Aryagarg23/makeuc-2026/research/tribe_v2/test12_mean.png

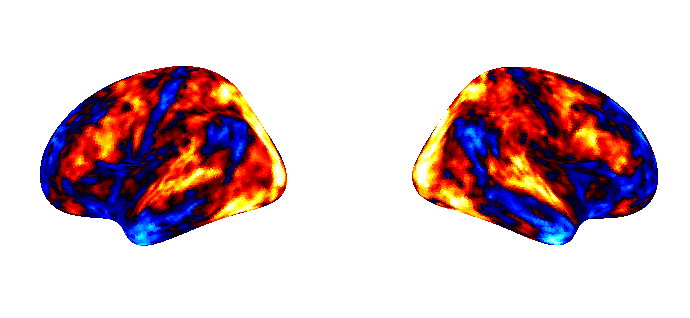
research/tribe_v2/test12_mean.png
