Aryagarg23/makeuc-2026/gvs/bench_log.md

# Bench log

Each run uses a 2.2 kΩ dummy load across the electrode leads, with nobody attached. Pulses are driven over USB serial by `tools/bench.py`. The board's reading is the firmware's own current readback; the meter reading is DC volts across the 2.2k, so true mA = V / 2.2.

## 2026-11-07

**Power.** With the battery feed wire on S1 col 19, the HV rail reads 3.85–3.89 V at idle on the board's own voltage reading.

**Boost sweep, open leads.** HV at each duty setting, on the board's own reading:

| Duty | 5% | 10% | 15% | 20% | 25% | 30% | 35% | 40% | 45% |
|---|---|---|---|---|---|---|---|---|---|
| HV (V) | 5.9 | 7.9 | 10.0 | 12.1 | 14.1 | 16.0 | 17.7 | 19.4 | 21.1 |

- 45% is the firmware ceiling (`BOOST_MAX_PCT`) and is now `BOOST_PCT`.
- During 3 s pulses with the leads open, HV peaked at 23–26.5 V. The cutoff is 28 V.
- Once the boost stops, HV bleeds back to about 3.9 V within about 1 s.

**Relays, open leads, 0.5 Hz sine.** The relay state went -1 → 0 → 1 → (-1) → 0 → -1: it alternated, and passed through released at each flip.

**Current into 2.2k, DC, 3 s:**

| Commanded | Meter | True current | Board's reading, before calibration | HV during pulse |
|---|---|---|---|---|
| 0.5 mA | 1.07 V | 0.486 mA | 0.69–0.72 | 21 V |
| 1.0 mA | 2.2 V | 1.00 mA | 1.13–1.14 | 19.5 V |
| 2.0 mA | 4.308 V | 1.958 mA | 1.92–2.03 | 17.0 V |

- With 0 mA commanded, the board read 0.25–0.28 mA, though no current was flowing. Taken together with the rows above, the uncorrected board reading follows **raw = 0.27 + 0.88 × true** in mA, so the error was in the measurement, not the output.
- The firmware now reports `meas_ma` with that correction. The overcurrent trip (2.3 mA) still uses the uncorrected reading, which runs at or above the true current up to about 2.25 mA.
- The meter reading at 0 mA commanded was not recorded.

## 2026-11-07, first on-head session (BLE, USB unplugged, Mac on battery)

Pads were placed on the mastoids. The kill switch had been removed; the plan was to pull a pad to stop.

| Time | Pulse | Felt |
|---|---|---|
| 22:48 | 0.5 mA, 1 Hz sine, 2 s | tingle |
| 22:49 | 0.75 mA, 1 Hz sine, 2 s | tingle |
| 22:49 | 1.0 mA, 1 Hz sine, 2 s | more tingle |
| 22:51 | 0.5 mA, 1/3 Hz sine, 3 s (pads moved) | (not reported) |
| 22:53–22:58 | DC 3 s at 1.0, 1.0, 1.25, 1.5, 1.5 mA, alternating sides | minor tingle |
| 23:04 | 1.0 mA DC (wire now cut into the pad's carbon layer) | stronger tingle |
| 23:12 | 1.0 mA DC (pads moved per diagram) | hurts a little / unusual |
| 23:13 | 1.25 mA DC | no balance change |
| 23:15 | 1.5 mA DC | hurts, on top of the skin; session stopped |

- **No vestibular effect at any level.** The board held the commanded current on every pulse, and there were no faults.
- **Likely cause: the electrode connection.** The pads have 2 mm female pin sockets. A bare wire was pushed into, then cut into, the carbon layer, so current reached the skin at a few points. That gives skin sensation, then pain, without enough current reaching the vestibular nerve.
- **Next session:**
  - Fresh pads, connected by 2 mm male pins (TENS lead wires or a tinned wire pin).
  - Check gel-to-gel resistance first: under about 1 kΩ, steady when the pins are wiggled.
  - During a 1.0 mA pulse, check that the voltage across the pads is 1–5 V.
  - Restart at 0.5 mA.

## 2026-11-08, battery flat overnight

- **Symptom:** Bluetooth not found.
- **On USB:** idle HV rail 2.48 V (3.75–3.88 V the night before), pulse log cleared, so the board had browned out and reset.
- **Charging over USB:** 2.82 → 3.11 V in 53 s.
- **Cause:** with no SSID, the firmware fell back to an always-on WiFi hotspot alongside BLE, and the 250 mAh LiPo couldn't sustain it overnight.
- **Fix:**
  - With no SSID, WiFi stays off and the HTTP server isn't started. The first build crashed in `xQueueSemaphoreTake` because `WebServer` touched lwIP while WiFi was off.
  - Boot now prints `WiFi off (no SSID)` and `BLE: GVS-zapper advertising`, and status works over BLE.
- **Battery:** went below about 3.0 V. Check it for swelling or heat while it recharges.

## 2026-11-08, live mode (browser tilt control)

- **Firmware:** `live <signed mA>` streams a target current. The board slews toward it at up to 4 mA/s, with the sign choosing the relay.
- **Limits:**
  - dead-man: 500 ms with no update ramps the output to 0 and ends the session
  - 60 s per session
  - 10 min of live time per rolling hour
  - |target| ≤ 1.5 mA
- **Checked over USB serial** at 0.3 mA, open leads or pads (not checked by meter):
  - streaming +0.3 holds 0.3 mA on relay 1
  - going silent reaches idle at 0.51 s, msg "live: controller silent, ramped off"
  - −0.3 mA moves to relay 2
  - −9 mA is clamped to −1.5
  - stop goes to idle
- **Relay (`ble_bridge.py`):**
  - Serves `live.html` at http://127.0.0.1:8765/; `/live?ma=` writes over BLE without waiting for a response.
  - Refuses any current (pulse, live, boost) while the Mac is on its charger **and** the board is on USB. Checked: `403 refused` for both /live and /cmd pulse while on AC with USB in.
- **A miss:** the serial checks above ran without that check, while the Mac was on AC with USB in.
