Aryagarg23/makeuc-2026/gvs/pictures/electrode_placement.png

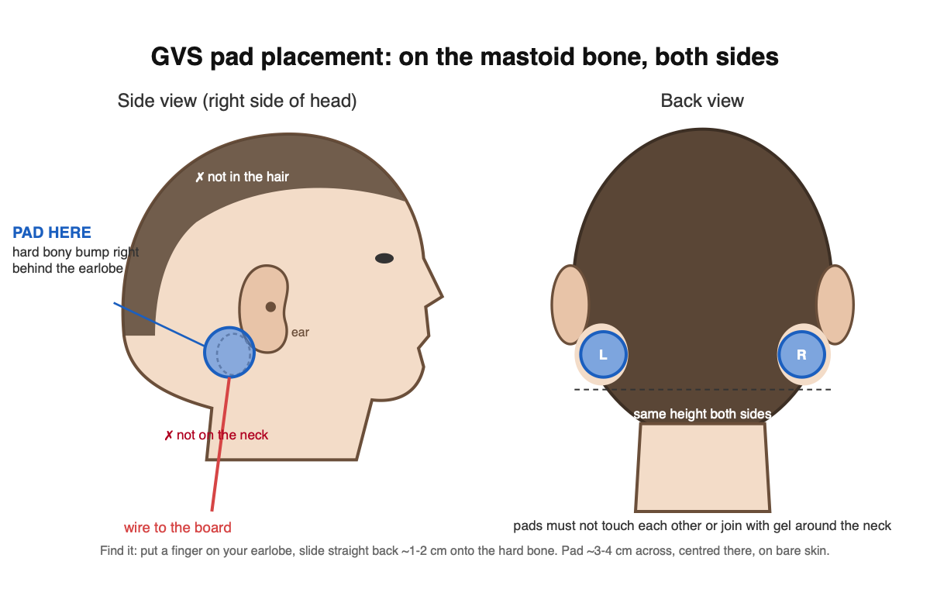
gvs/pictures/electrode_placement.png
