Aryagarg23/makeuc-2026/gvs/pictures/full_front.png

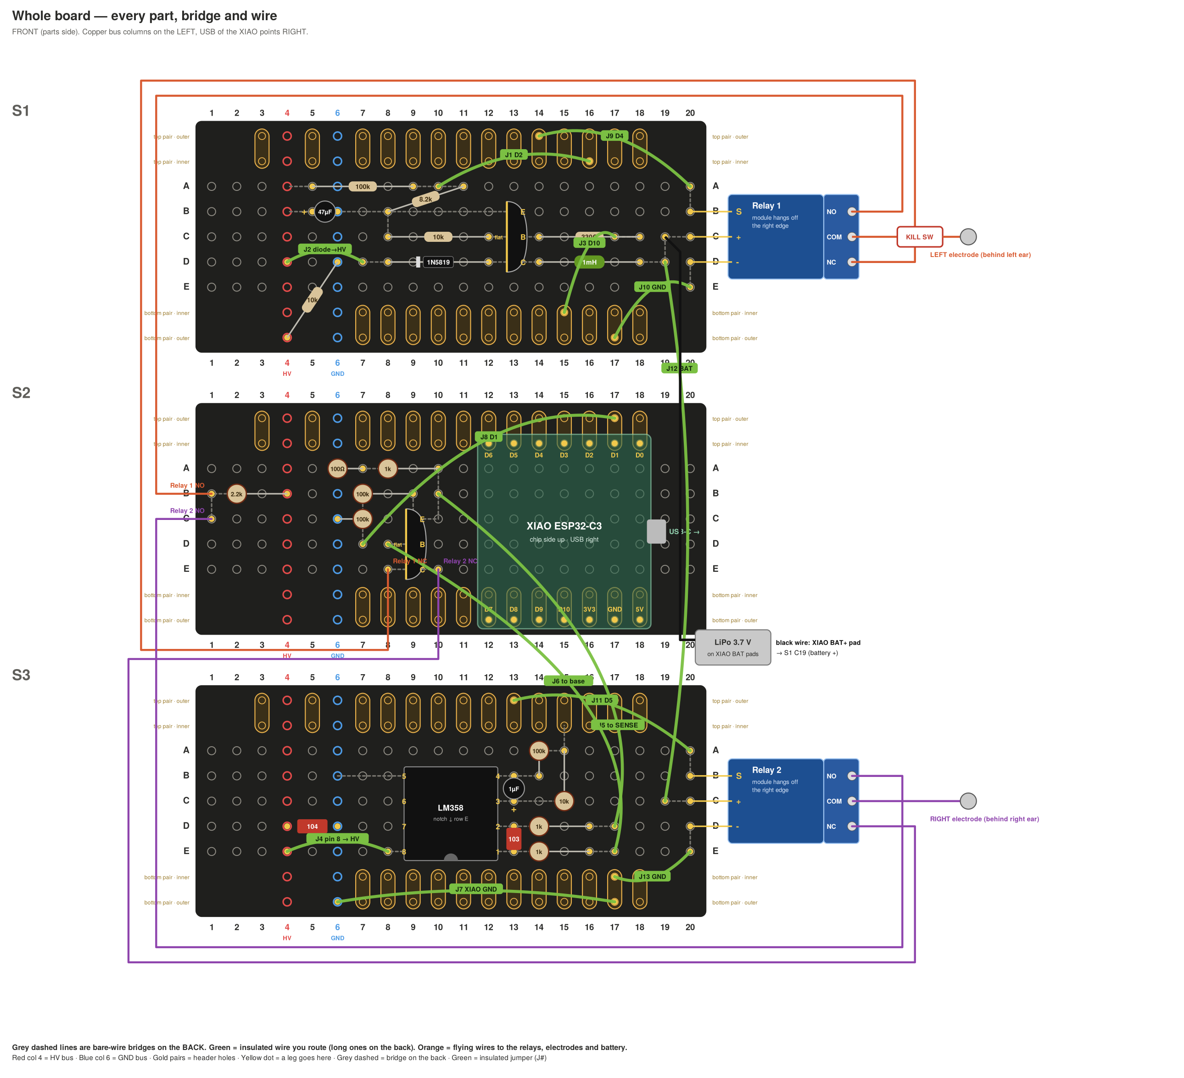
gvs/pictures/full_front.png
