Aryagarg23/makeuc-2026/gvs/pictures/S1_back.png

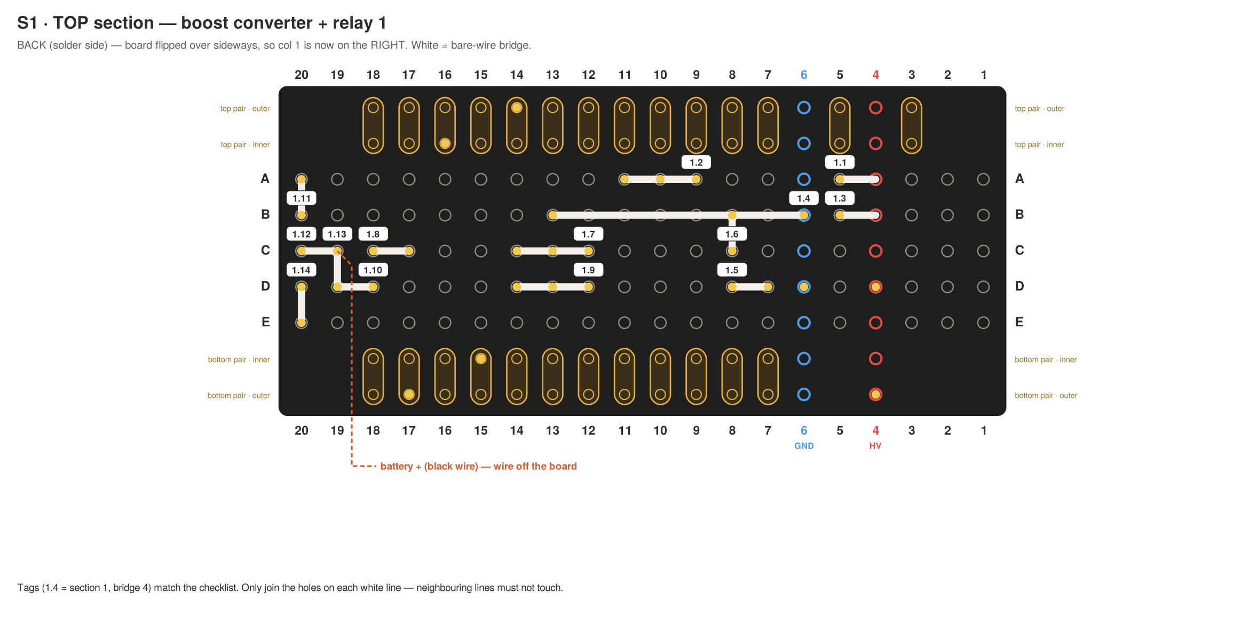
gvs/pictures/S1_back.png
