Aryagarg23/makeuc-2026/gvs/pictures/S1_front.png

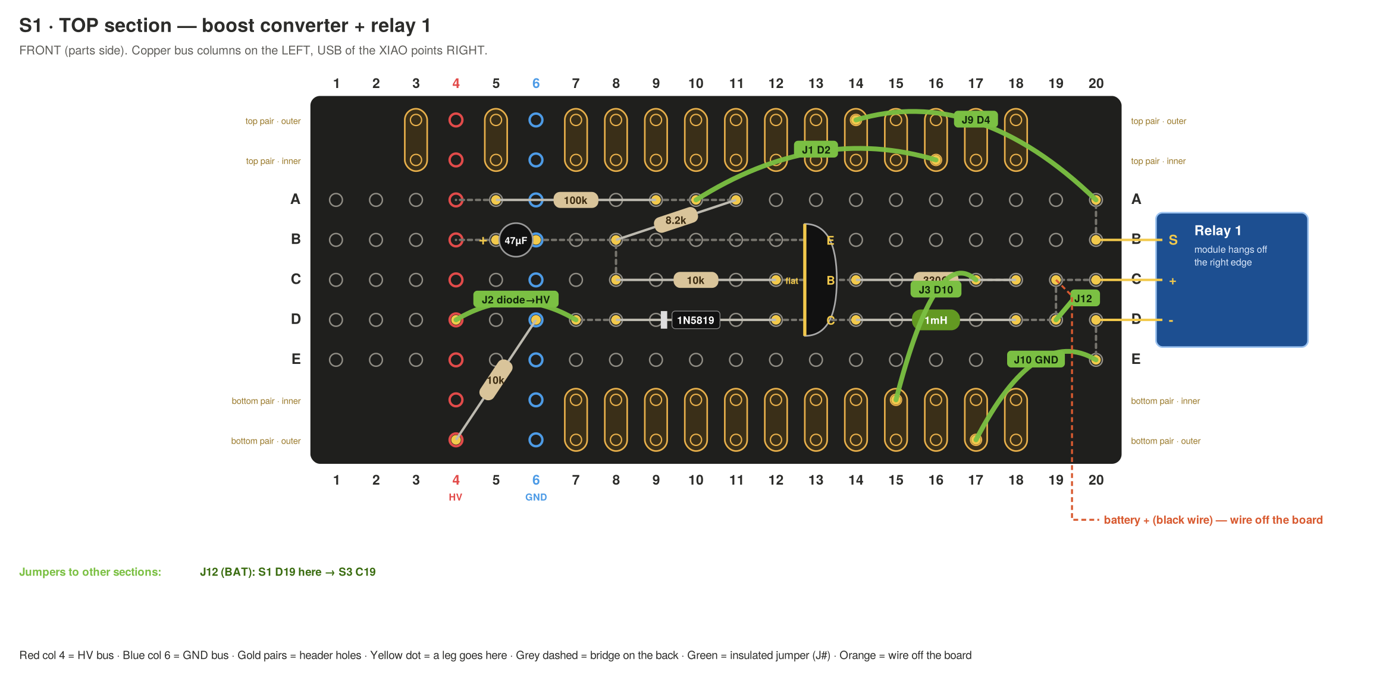
gvs/pictures/S1_front.png
