Aryagarg23/makeuc-2026/gvs/pictures/S2_back.png

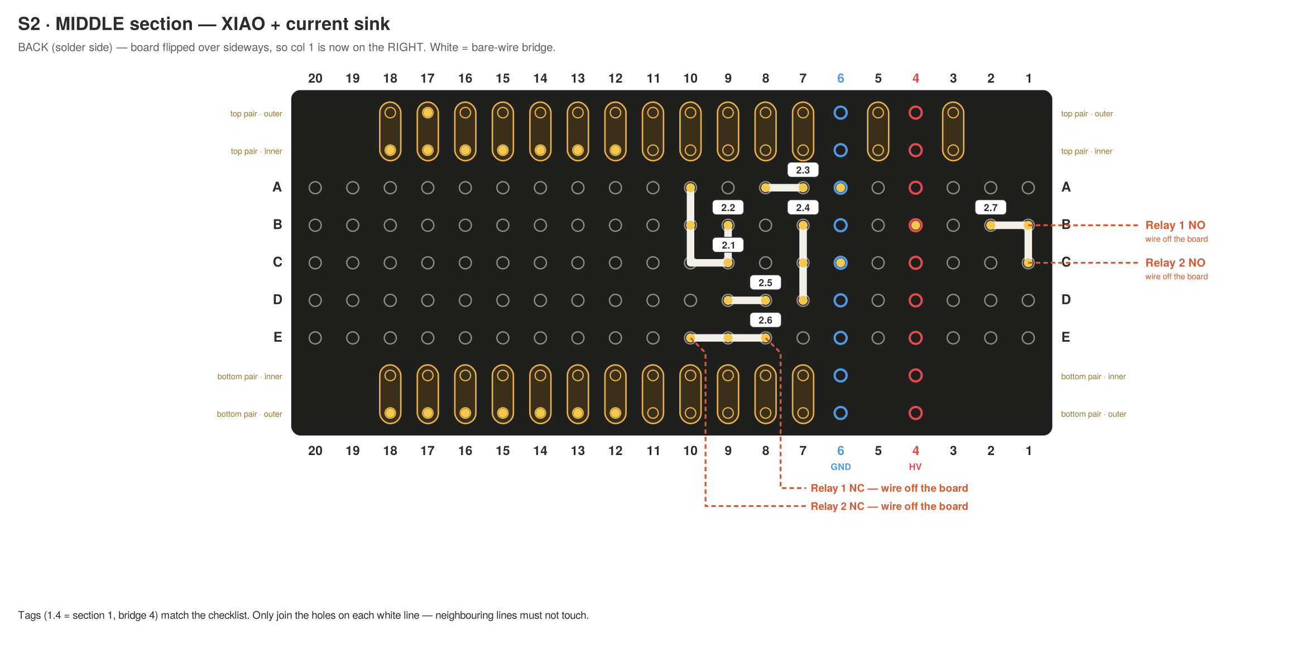
gvs/pictures/S2_back.png
