Aryagarg23/makeuc-2026/gvs/pictures/S2_front.png

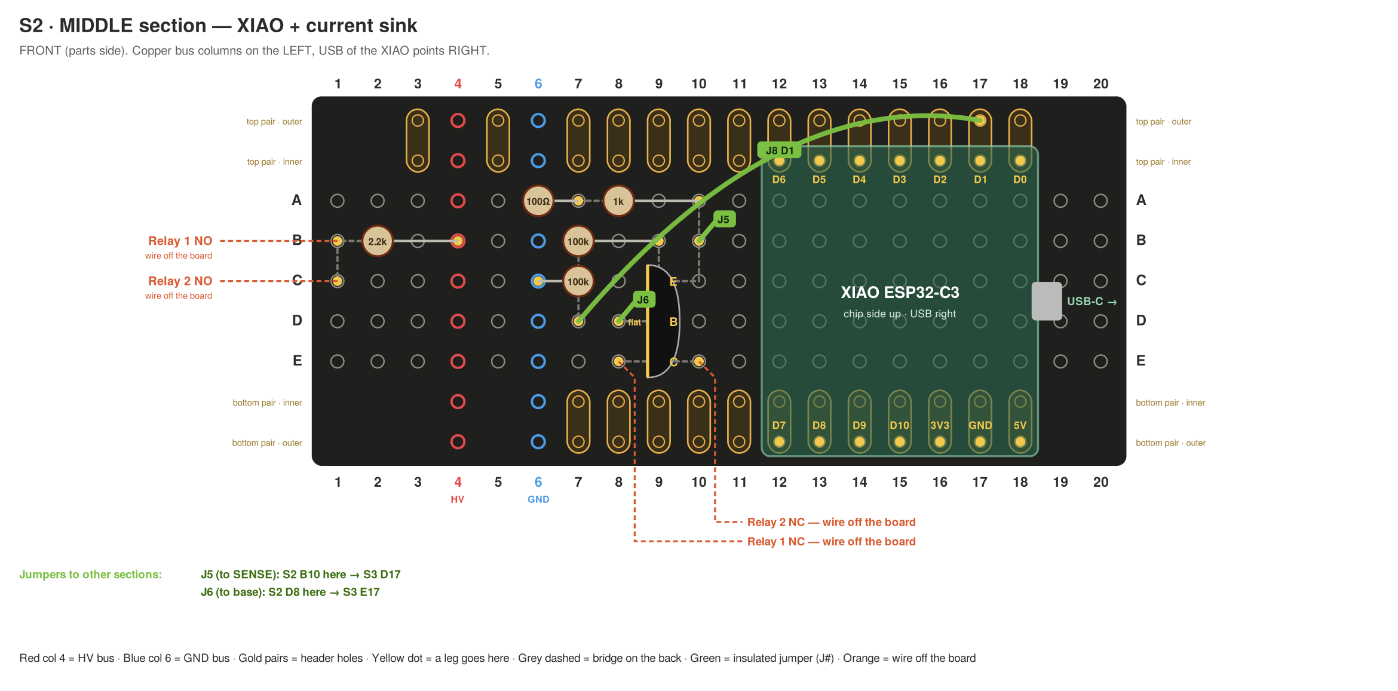
gvs/pictures/S2_front.png
