Aryagarg23/makeuc-2026/gvs/pictures/S3_back.png

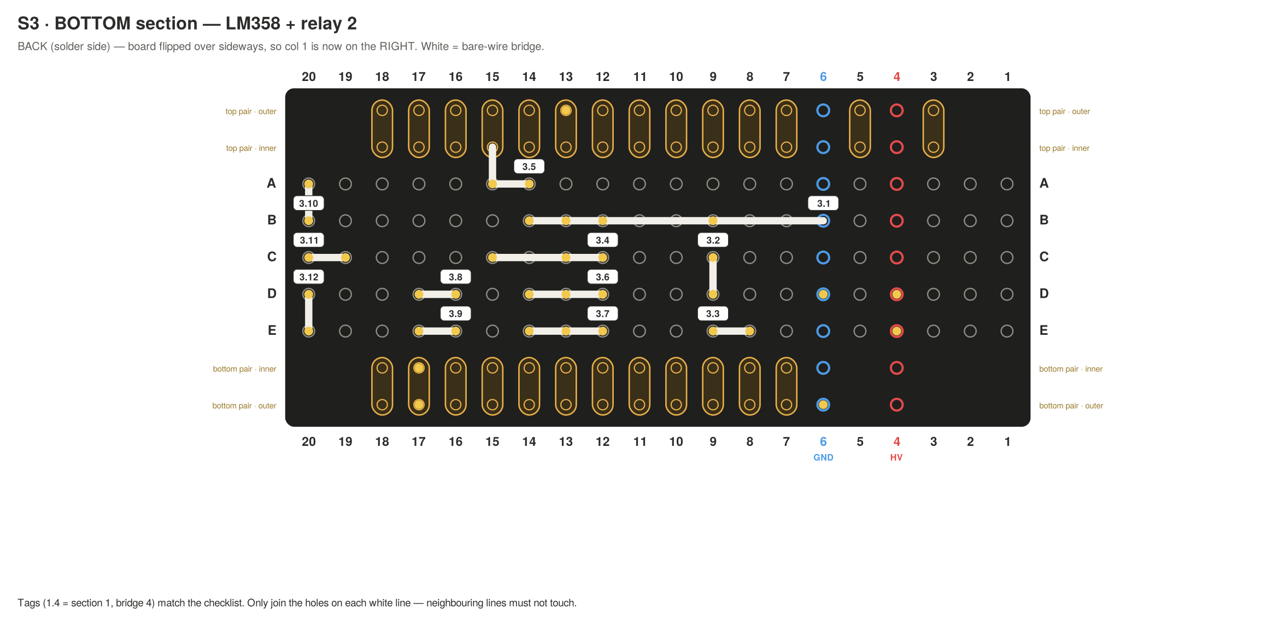
gvs/pictures/S3_back.png
