Aryagarg23/makeuc-2026/gvs/pictures/S3_front.png

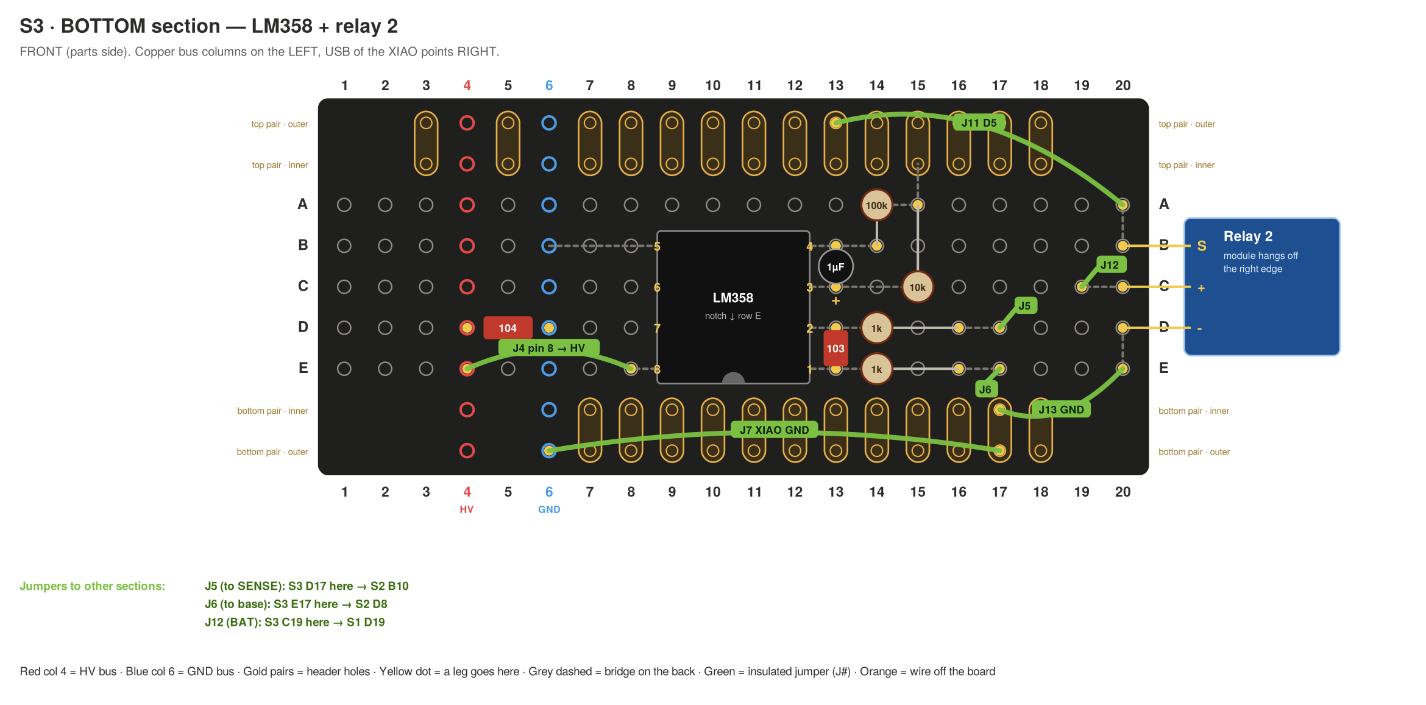
gvs/pictures/S3_front.png
