Aryagarg23/makeuc-2026/video/assets/software_map.png

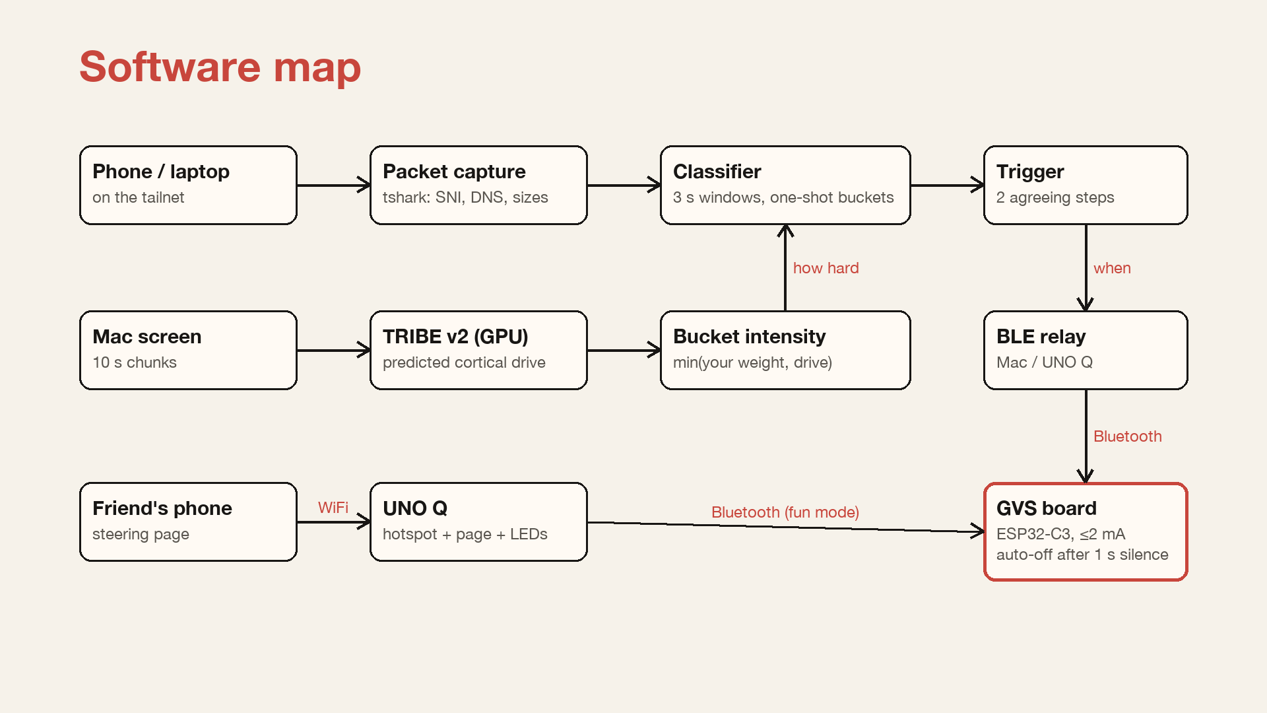
video/assets/software_map.png
