Aryagarg23/makeuc-2026/gvs/build_guide.html

# GVS perfboard build guide

Particle FeatherWing Tripler · col 4 = HV bus · col 6 = GND bus · gold pairs = header pins (bussed between sections; only the XIAO and the listed jumpers touch them). Layout checked hole-by-hole against the circuit and simulated in ngspice (0 mA idle, 1 / 2 mA exact, 19.5 V max boost, shorted-transistor fault caught).

Whole board with every wire (tap to open)

Whole board

Work one section at a time: back bridges first, then parts lowest to tallest, then insulated wires. Pinch the pictures to zoom; turn your phone sideways.

## 0 · Before you solder

- Hold the board like the pictures: copper bus columns near the LEFT, XIAO in the middle section, USB pointing right.
- Hole names: S2 B10 = section 2, row B, column 10. Header holes are called top/bottom pair, inner/outer (inner = the one next to row A or E).
- Beep test: col 4 (HV bus) to col 6 (GND bus) must NOT beep.

## Section 1 (top) — boost converter + relay 1

Front (parts):

Section 1 front

Back (solder side, flipped over sideways; tags match the steps):

Section 1 back

- 1.1 Back bridge: S1 A5 → S1 A4.
- 1.2 Back bridge: S1 A9 → S1 A10 → S1 A11.
- 1.3 Back bridge: S1 B5 → S1 B4.
- 1.4 Back bridge: S1 B6 → S1 B7 → S1 B8 → S1 B9 → S1 B10 → S1 B11 → S1 B12 → S1 B13.
- 1.5 Back bridge: S1 D8 → S1 D7.
- 1.6 Back bridge: S1 C8 → S1 B8.
- 1.7 Back bridge: S1 C12 → S1 C13 → S1 C14.
- 1.8 Back bridge: S1 C18 → S1 C17.
- 1.9 Back bridge: S1 D12 → S1 D13 → S1 D14.
- 1.10 Back bridge: S1 D18 → S1 D19.
- 1.11 Back bridge: S1 B20 → S1 A20.
- 1.12 Back bridge: S1 C20 → S1 C19.
- 1.13 Back bridge: S1 C19 → S1 D19.
- 1.14 Back bridge: S1 D20 → S1 E20.
- 100k resistor, lying flat: S1 A5 and S1 A9.
- 8.2k resistor, lying flat: S1 B8 and S1 A11.
- 10k resistor, lying flat: S1 col 4 bottom pair, outer hole and S1 D6.
- 10k resistor, lying flat: S1 C12 and S1 C8.
- 330Ω resistor, lying flat: S1 C14 and S1 C18.
- 1N5819 diode: stripe end in S1 D8, other end in S1 D12.
- 1mH inductor (green), either way round: S1 D14 and S1 D18.
- 47µF electrolytic: long leg (+) in S1 B5, stripe leg (−) in S1 B6.
- 2N3904 (Q1): E in S1 B13, B in S1 C13, C in S1 D13. Flat face toward the LEFT.
- J1 Insulated wire D2: S1 A10 → S1 col 16 top pair, inner hole.
- J2 Insulated wire diode→HV: S1 D7 → S1 D4.
- J3 Insulated wire D10: S1 C17 → S1 col 15 bottom pair, inner hole.
- J9 Insulated wire D4: S1 A20 → S1 col 14 top pair, outer hole.
- J10 Insulated wire GND: S1 E20 → S1 col 17 bottom pair, outer hole.
- J12 Insulated wire BAT: S3 C19 → S1 D19.
- off battery + (black wire) wire into S1 C19.

## Section 2 (middle) — XIAO + current sink

Front (parts):

Section 2 front

Back (solder side, flipped over sideways; tags match the steps):

Section 2 back

- 2.1 Back bridge: S2 C9 → S2 C10 → S2 B10 → S2 A10.
- 2.2 Back bridge: S2 B9 → S2 C9.
- 2.3 Back bridge: S2 A7 → S2 A8.
- 2.4 Back bridge: S2 B7 → S2 C7 → S2 D7.
- 2.5 Back bridge: S2 D8 → S2 D9.
- 2.6 Back bridge: S2 E8 → S2 E9 → S2 E10.
- 2.7 Back bridge: S2 B2 → S2 B1 → S2 C1.
- 1k resistor, standing up: body over S2 A8, top lead bent down into S2 A10.
- 100Ω resistor, standing up: body over S2 A6, top lead bent down into S2 A7.
- 100k resistor, standing up: body over S2 B7, top lead bent down into S2 B9.
- 100k resistor, standing up: body over S2 C7, top lead bent down into S2 C6.
- 2.2k resistor, standing up: body over S2 B2, top lead bent down into S2 B4.
- 2N3904 (Q2): E in S2 C9, B in S2 D9, C in S2 E9. Flat face toward the LEFT.
- J5 Insulated wire to SENSE: S3 D17 → S2 B10.
- J6 Insulated wire to base: S3 E17 → S2 D8.
- J8 Insulated wire D1: S2 D7 → S2 col 17 top pair, outer hole.
- off Relay 1 NC wire into S2 E8.
- off Relay 2 NC wire into S2 E10.
- off Relay 1 NO wire into S2 B1.
- off Relay 2 NO wire into S2 C1.

## Section 3 (bottom) — LM358 + relay 2

Front (parts):

Section 3 front

Back (solder side, flipped over sideways; tags match the steps):

Section 3 back

- 3.1 Back bridge: S3 B6 → S3 B7 → S3 B8 → S3 B9 → S3 B10 → S3 B11 → S3 B12 → S3 B13 → S3 B14.
- 3.2 Back bridge: S3 C9 → S3 D9.
- 3.3 Back bridge: S3 E9 → S3 E8.
- 3.4 Back bridge: S3 C12 → S3 C13 → S3 C14 → S3 C15.
- 3.5 Back bridge: S3 A14 → S3 A15 → S3 col 15 top pair, inner hole.
- 3.6 Back bridge: S3 D12 → S3 D13 → S3 D14.
- 3.7 Back bridge: S3 E12 → S3 E13 → S3 E14.
- 3.8 Back bridge: S3 D16 → S3 D17.
- 3.9 Back bridge: S3 E16 → S3 E17.
- 3.10 Back bridge: S3 B20 → S3 A20.
- 3.11 Back bridge: S3 C20 → S3 C19.
- 3.12 Back bridge: S3 D20 → S3 E20.
- 10k resistor, standing up: body over S3 C15, top lead bent down into S3 A15.
- 100k resistor, standing up: body over S3 A14, top lead bent down into S3 B14.
- 1k resistor, standing up: body over S3 D14, top lead bent down into S3 D16.
- 1k resistor, standing up: body over S3 E14, top lead bent down into S3 E16.
- 104 capacitor (red box), either way round: S3 D4 and S3 D6.
- 103 capacitor (red box), either way round: S3 D13 and S3 E13.
- 1µF electrolytic: long leg (+) in S3 C13, stripe leg (−) in S3 B13.
- LM358: pin 1 in S3 E12, pin 8 in S3 E9; notch/dot toward row E (down).
- J4 Insulated wire pin 8 → HV: S3 E8 → S3 E4.
- J7 Insulated wire XIAO GND: S3 col 17 bottom pair, outer hole → S3 col 6 bottom pair, outer hole.
- J11 Insulated wire D5: S3 A20 → S3 col 13 top pair, outer hole.
- J13 Insulated wire GND: S3 E20 → S3 col 17 bottom pair, inner hole.

## Section 1 (top) — boost converter + relay 1

Front (parts):

Back (solder side, flipped over sideways; tags match the steps):

- Battery: add a second wire on the XIAO BAT+ pad (already has the battery) and bring it to S1 D18.

## Section 3 (bottom) — LM358 + relay 2

Front (parts):

Back (solder side, flipped over sideways; tags match the steps):

- Run the long wires (J11 battery, J12 GND) along the back so they don't block the USB-C port.

## 4 · Relays, electrodes, kill switch

- Relays sit in col 20, rows B/C/D. Read the labels by the pins: this layout assumes S, +, − top to bottom. If yours read −, +, S, swap that relay's S wire and GND wire.
- Relay screw terminals: NO and NC wires go to the holes shown in section 2. Relay 1 COM → kill switch → left electrode. Relay 2 COM → right electrode.
- Firmware: RELAY_ACTIVE_LOW = false (red module: jumper on H).

## 6 · Beep checks before power

- Beep HV (col 4) ↔ GND (col 6): must NOT beep.
- Beep BAT (S1 D18) ↔ GND: must NOT beep.
- Beep XIAO 5V pin ↔ BAT and 5V ↔ GND: must NOT beep.
- Beep XIAO GND pin ↔ col 6: MUST beep.
- Look over the back with a light: no solder blob touching a neighbouring pad, especially next to the header pairs.

## 7 · First power-up

- Battery charged, USB to laptop, firmware flashed with BOOST_PCT = 0.
- Meter on HV ↔ GND: about 3.5–3.9 V (battery passing through).
- Tune the boost: /boost?pct=5, then +5% at a time until about 24 V on a full battery. Never above 28 V. Put the number in BOOST_PCT, reflash, then /boost?pct=0.
- Test 1: 2.2k resistor across the two electrode leads. /pulse?ma=1&mode=dc&ms=3000 → about 2.2 V across the resistor (1 mA).
- Test 2: idle and reboot read 0 V across the resistor; pol=1 flips the sign; the kill switch cuts it; mode=sine&hz=0.5 → relays click, meter swings ±.
- Only after all of that: unplug USB, electrodes behind the ears, sit down, start at 0.5 mA.

Clear all ticks
