Aryagarg23/makeuc-2026/gvs/pictures/probe_steps.png

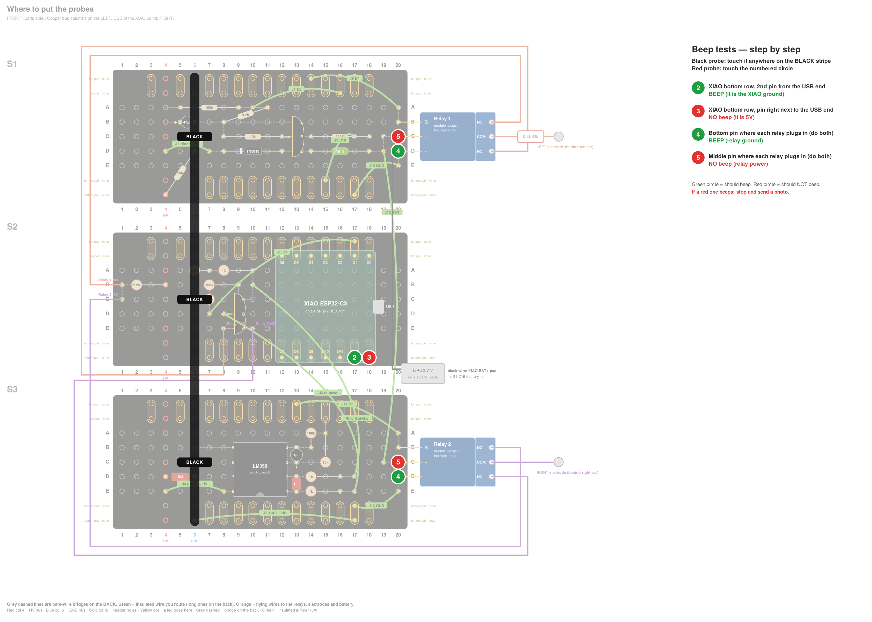
gvs/pictures/probe_steps.png
