Aryagarg23/makeuc-2026/gvs/pictures/test_points.png

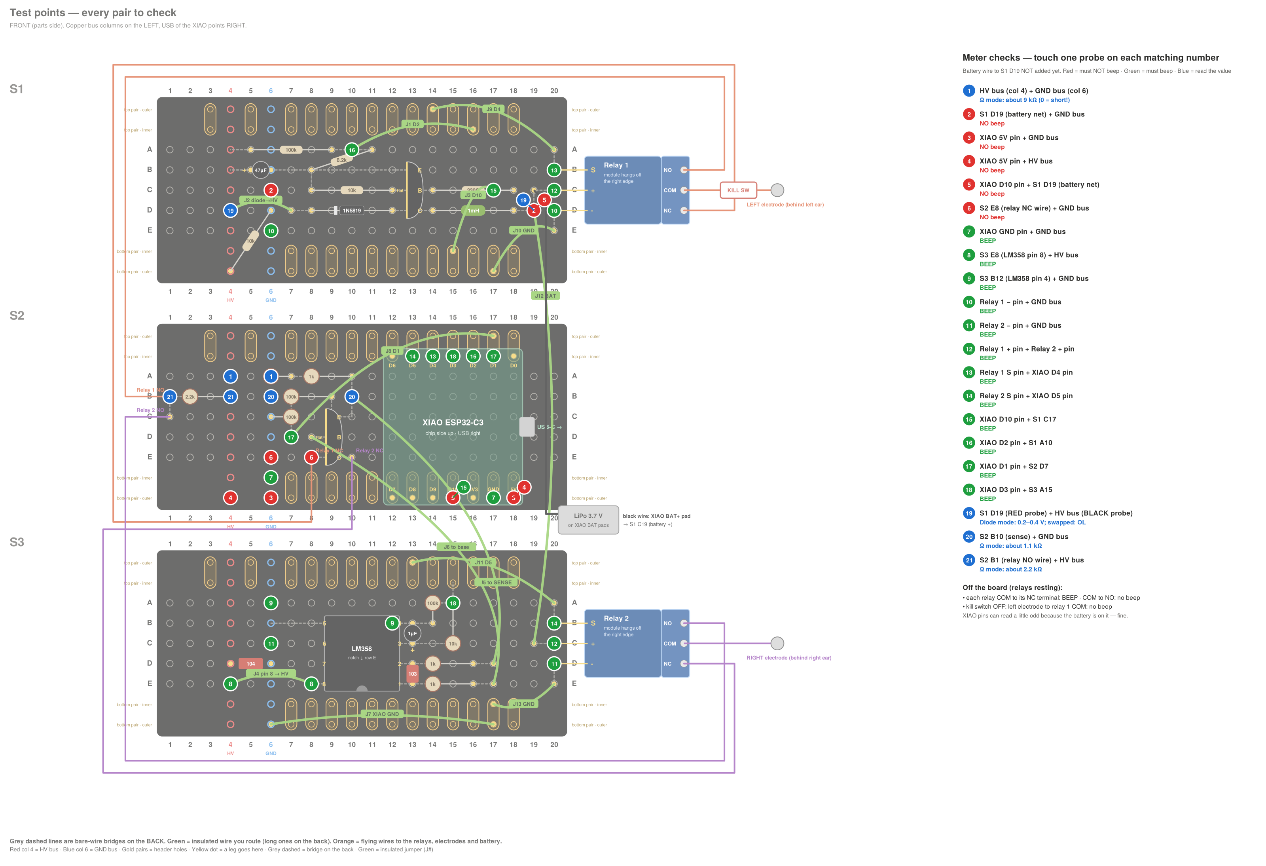
gvs/pictures/test_points.png
