Aryagarg23/makeuc-2026/(commit log)

2026-11-07 ESP32 GVS controller firmware, SD card layout and the packet-to-stimulus pipeline
    [trials.csv]
2026-11-07 Classifier: split buckets that share a domain by flow shape; 3 s sliding windows with a two-step confirm
    Reels and DMs use the same servers, so a domain alone can't tell them apart. The
    windows now slide every second and a stimulus needs two matching windows in a row.
    Research notes on conditioning, traffic fingerprinting and the UNO Q as an exit node.
2026-11-08 Import the built GVS device: fix the PWM, flash it, bench-test it and calibrate it
    The ESP32-C3's PWM only attaches at 10 bits, so 12-bit pulses commanded 0 mA while
    reporting success. The firmware now faults at boot if a PWM does not attach.
    Bench: current within 3% at 0.5, 1 and 2 mA, readback calibrated, boost tuned to 45%.
    bench.py runs the timed safety suite and the hourly-cap test.
    [trials.csv]
2026-11-08 BLE control with token-prefixed commands shared with serial, and a Mac relay for it
2026-11-08 First on-head session: log it, add the electrode placement diagram, write the debug notes
    Tingle that turned into pain and no balance effect, most likely from a bare wire in the
    pad. DEBUG.md compares the circuit with published builds and lists meter checks, the
    session protocol and hardware changes, and the electrode size evidence.
2026-11-08 Firmware: keep WiFi off without an SSID
    The always-on hotspot flattened the 250 mAh LiPo overnight. Without an SSID the HTTP
    server does not start either.
2026-11-08 Live tilt control: firmware live mode with a dead-man and a current budget, and a browser page
    The board slews toward a streamed current and drops to zero when updates stop. The
    budget counts only time with current flowing. The tilt cap is the firmware's 2.0 mA.
2026-11-08 Pipeline: send stimuli through the BLE relay, and refuse them when the Mac is on its charger
2026-11-08 Fun mode: the UNO Q serves a hotspot and a steering page and drives the board over Bluetooth
    BLE range raised (TX +18 dBm). The UNO Q feeds the dead-man itself at 10 Hz and drops to
    0 mA when the page goes quiet. A supervisor started from cron restarts the server within
    2 s. The live budget is 30 minutes of current per hour.
2026-11-08 Pitch video: the cut-together tools, the cyber look, and scene 1
2026-11-08 Pitch video: scene 2, the window-cloning transition and the ending
2026-11-08 Pipeline: live-editable packet rules and a dashboard to choose what makes me dizzy
    Per-service weights (0 = never), per-bucket on/off and weight, and pause, re-read every
    window. A service rule can fire an app nobody enrolled or veto one a bucket matches.
2026-11-08 Document the build: safety, hardware, pinout, build, testing and software
    Schematic, wiring and software figures, the perfboard jumpers J1 to J13, every test and
    measurement, and a disclaimer on how it can go wrong.
    [schematic.py, site_figures.py]
